ostojaatanasijevic/tube_screamer/README.md

# TPI pedals - TBSCR

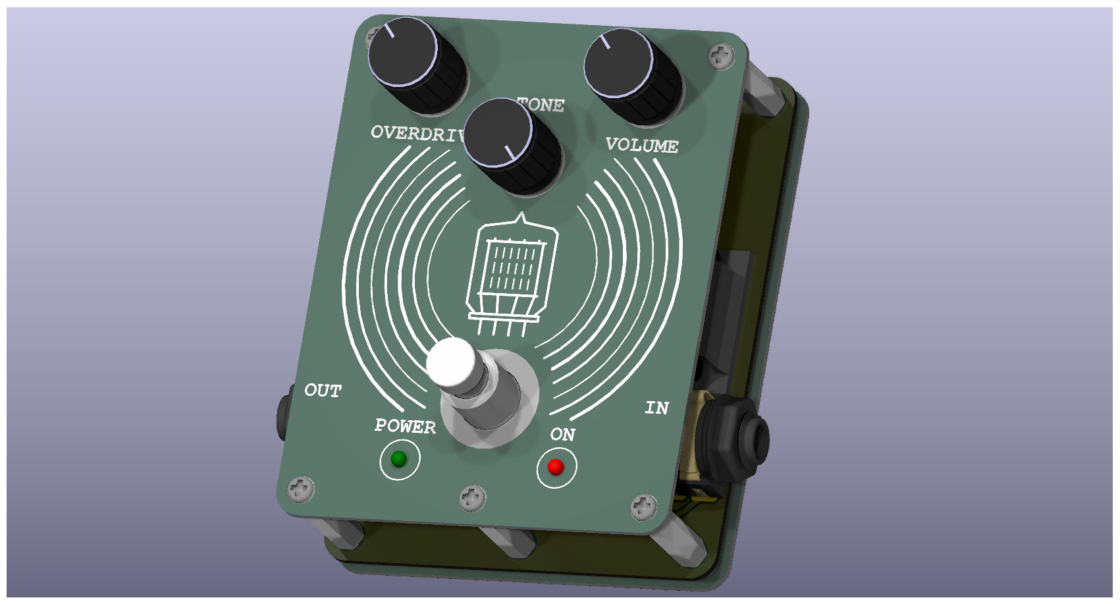
[picture p1: tube_screamer/tube_screamer_side.png]
side_view

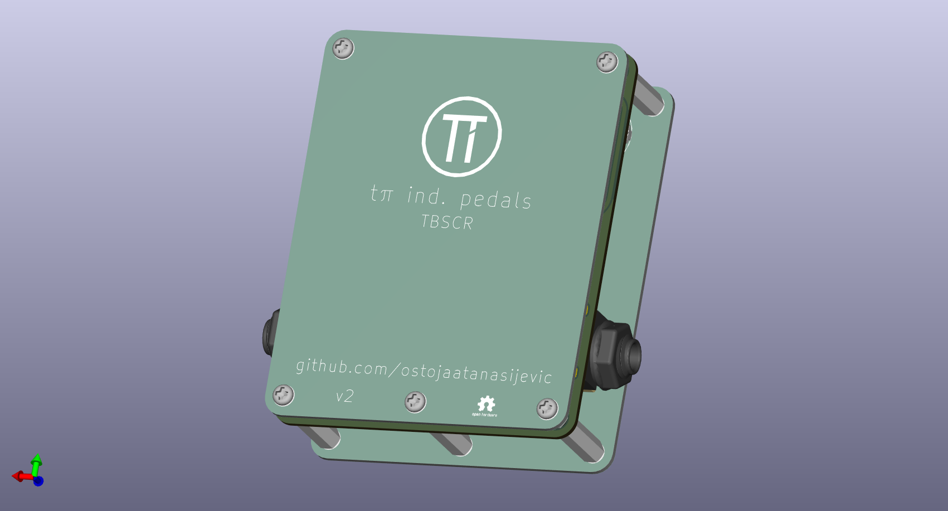
[picture p2: tube_screamer/tube_screamer_bottom.png]
top_view


## Schematic
schematic
