ostojaatanasijevic/tube_screamer/tube_screamer/tube_screamer_top.png

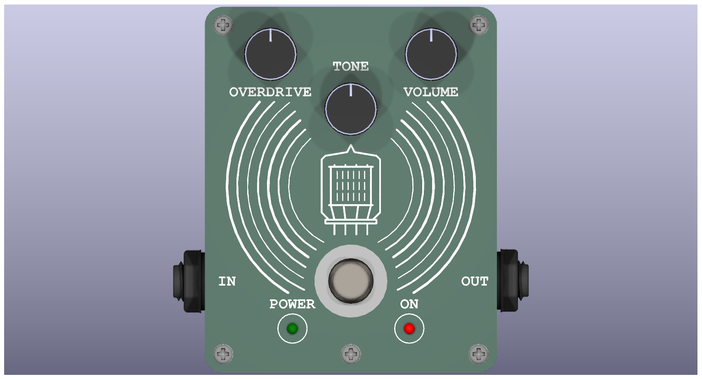
tube_screamer/tube_screamer_top.png
