ostojaatanasijevic/tube_screamer/bottom_plate.step

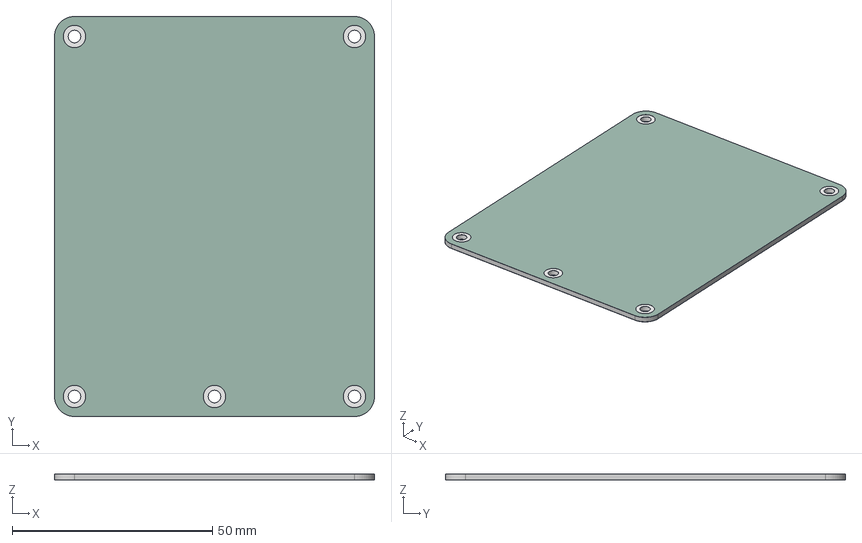
[picture p4: CAD file, 2025-05-22]
bottom_plate.step
80.0 x 100.0 x 1.64 mm
tube_screamer_bottom_plate_pad
tube_screamer_bottom_plate_silkscreen
tube_screamer_bottom_plate_soldermask
tube_screamer_bottom_plate_PCB
