ostojaatanasijevic/tube_screamer/tube_screamer_bottom_plate/tube_screamer_bottom_plate.step

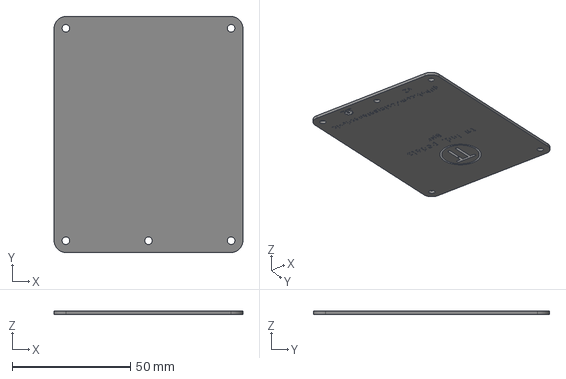
[picture p5: CAD file, 2025-05-13]
tube_screamer_bottom_plate/tube_screamer_bottom_plate.step
80.0 x 100.0 x 1.58 mm
big_muff_pi_bottom_plate_silkscreen
big_muff_pi_bottom_plate_PCB
