ostojaatanasijevic/tube_screamer/tube_screamer_front_plate/tube_screamer_front_plate.step

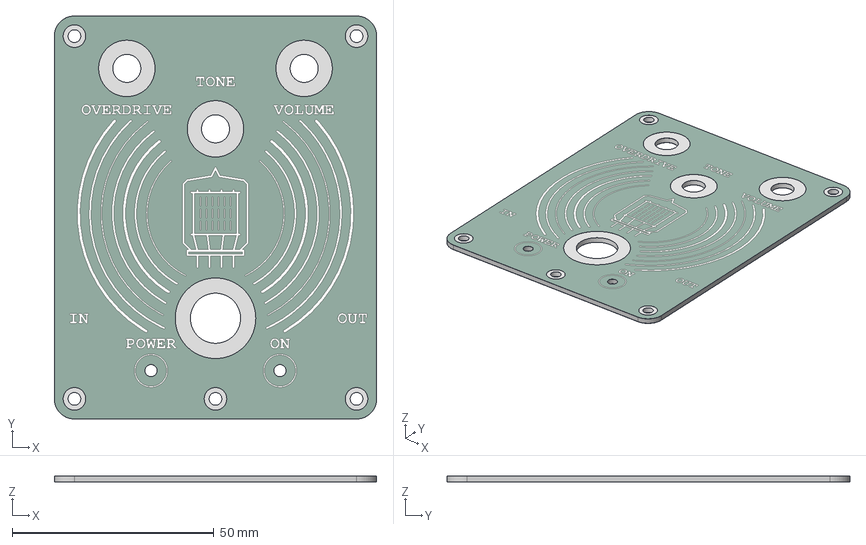
[picture p6: CAD file, 2025-04-02]
tube_screamer_front_plate/tube_screamer_front_plate.step
80.0 x 100.0 x 1.66 mm
tube_screamer_front_plate_copper
tube_screamer_front_plate_pad
tube_screamer_front_plate_silkscreen
tube_screamer_front_plate_soldermask
tube_screamer_front_plate_PCB
