ostojaatanasijevic/tube_screamer/top_plate.step

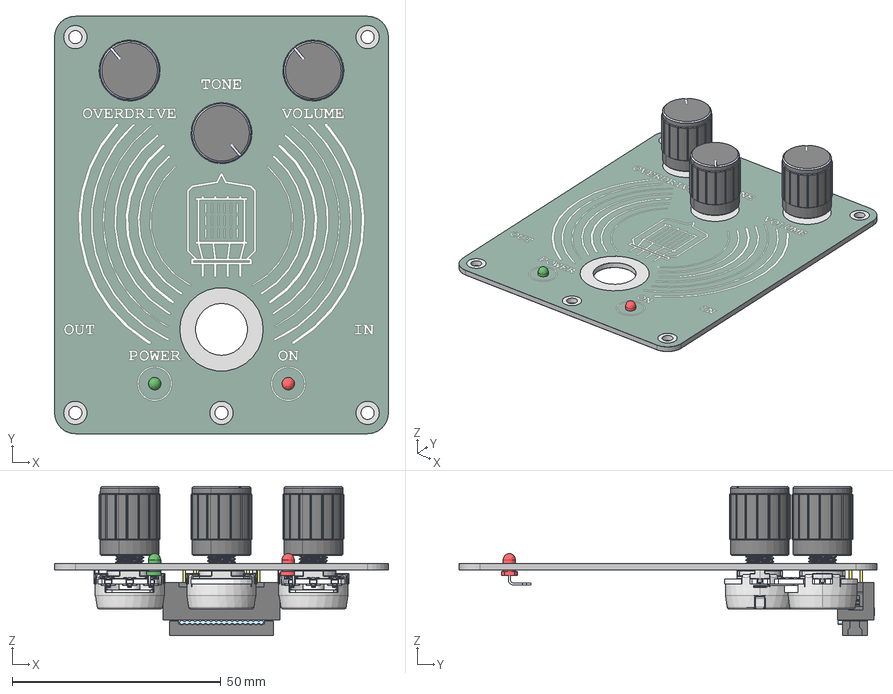
[picture p7: CAD file, 2025-05-22]
top_plate.step
80.0 x 100.0 x 35.8 mm
pcb board x 3
base metal x 3
rotating rod metal x 3
pin x 9
sheild metal x 3
plastic base x 3
Potentiometer knob_A15x17-PK-AB-K-I x 3
LED 3mm, Green, Thru-hole, Right Angle PCB 1
LED 3mm, Red, Thru-hole, Right Angle PCB 1
IDC-Header_2x08_P2.54mm_Vertical
case
clamp
tube_screamer_front_plate_pad
tube_screamer_front_plate_silkscreen
tube_screamer_front_plate_soldermask
tube_screamer_front_plate_PCB
