ostojaatanasijevic/tube_screamer/tube_screamer_bottom_plate/top_plate.step

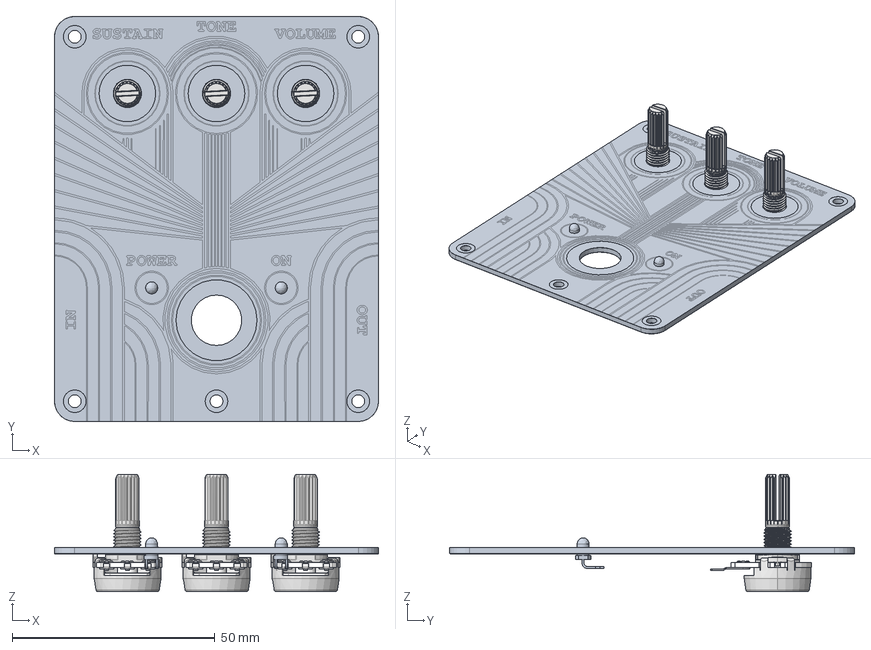
[picture p8: CAD file, 2025-05-13]
tube_screamer_bottom_plate/top_plate.step
80.0 x 100.0 x 29.0 mm
pcb board x 3
base metal x 3
rotating rod metal x 3
pin x 9
sheild metal x 3
plastic base x 3
LED 3mm, Red, Thru-hole, Right Angle PCB 1
LED 3mm, Green, Thru-hole, Right Angle PCB 1
big_muff_pi_front_plate_copper
big_muff_pi_front_plate_pad
big_muff_pi_front_plate_silkscreen
big_muff_pi_front_plate_soldermask
big_muff_pi_front_plate_PCB
