ostojaatanasijevic/tube_screamer/tube_screamer_bottom_plate/3-d-nmj6hhd2.stp

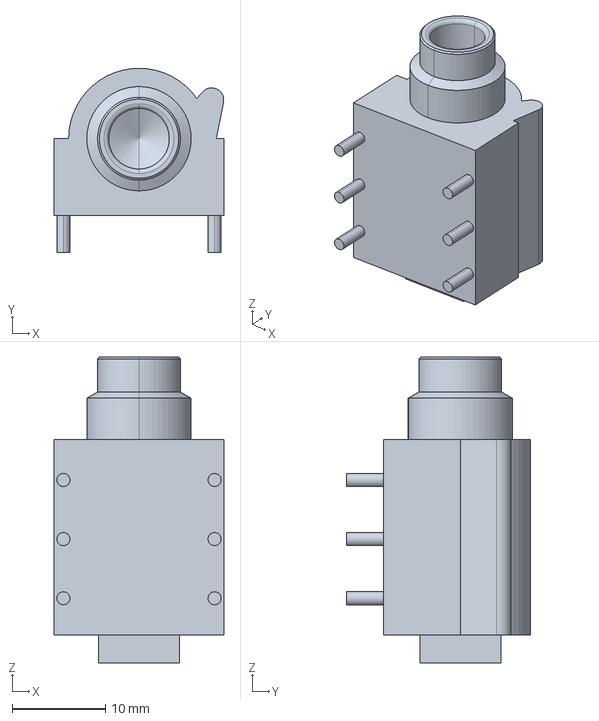
[picture p9: CAD file, 2025-04-05]
tube_screamer_bottom_plate/3-d-nmj6hhd2.stp
18.2 x 19.8 x 32.9 mm
