ostojaatanasijevic/tube_screamer/tube_screamer_bottom_plate/9V-battery.stp

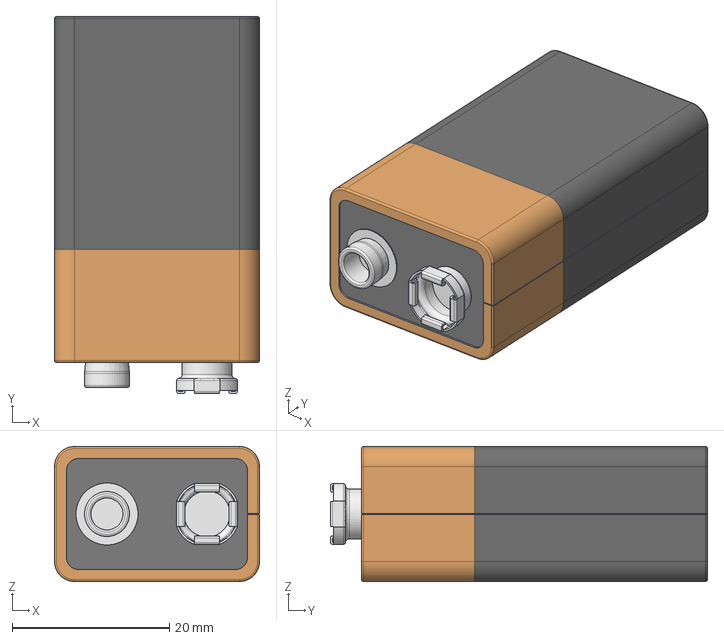
[picture p10: CAD file, 2025-04-01]
tube_screamer_bottom_plate/9V-battery.stp
26.0 x 47.9 x 17.1 mm
