ostojaatanasijevic/tube_screamer/tube_screamer_bottom_plate/NMJ6HFD2-AU--3DModel-STEP-418109.STEP

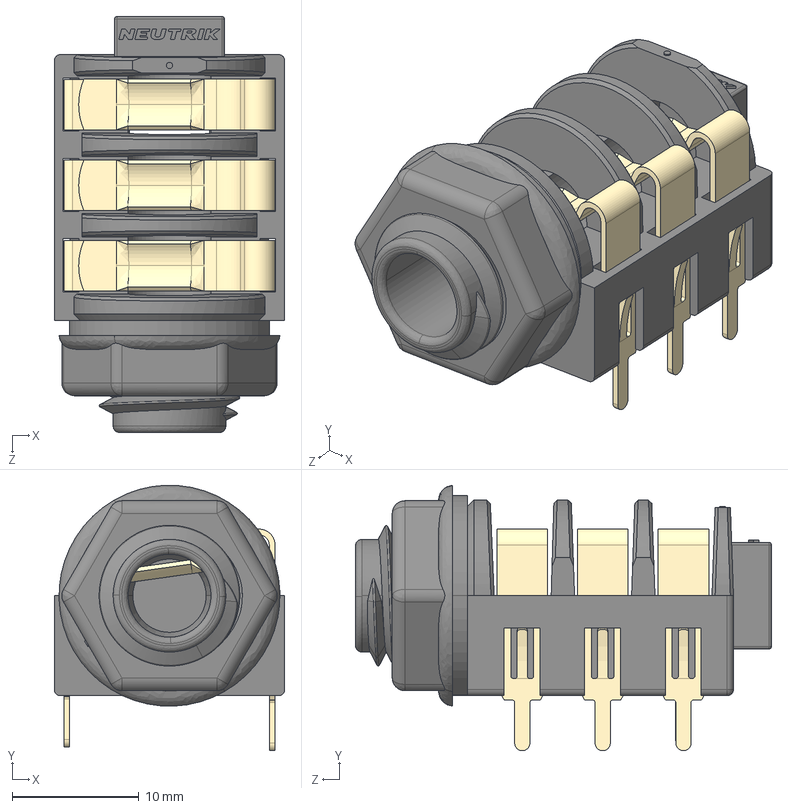
[picture p11: CAD file, 2025-04-01]
tube_screamer_bottom_plate/NMJ6HFD2-AU--3DModel-STEP-418109.STEP
18.2 x 21.0 x 32.9 mm
