ostojaatanasijevic/tube_screamer/tube_screamer_bottom_plate/switch.STEP

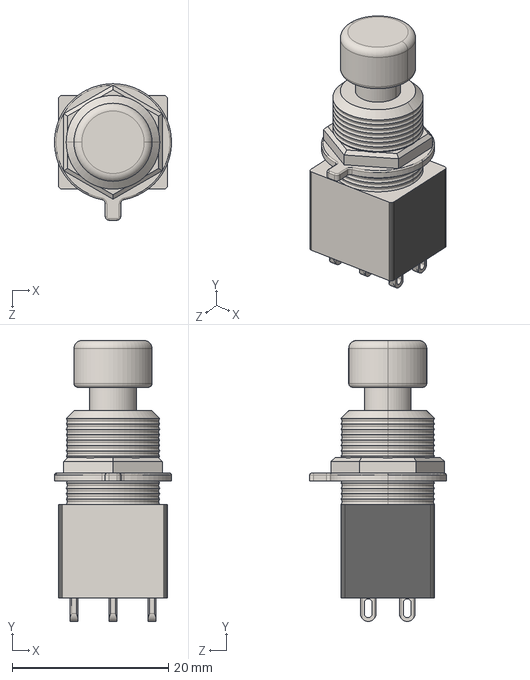
[picture p12: CAD file, 2025-04-01]
tube_screamer_bottom_plate/switch.STEP
15.0 x 36.0 x 17.5 mm
