ostojaatanasijevic/tube_screamer/pmos_enable.asc

M1: nmos; KP723A
M2: pmos; FDS4435A
R1: res; 100
R2: res; 100k
R3: res; 100k
V2: voltage; 10
Named nets: 0
.tran 1m
