ostojaatanasijevic/tube_screamer/tube_screamer/tube_screamer.kicad_pcb

## KiCad design tube_screamer/tube_screamer.kicad_pcb (2025-05-24)

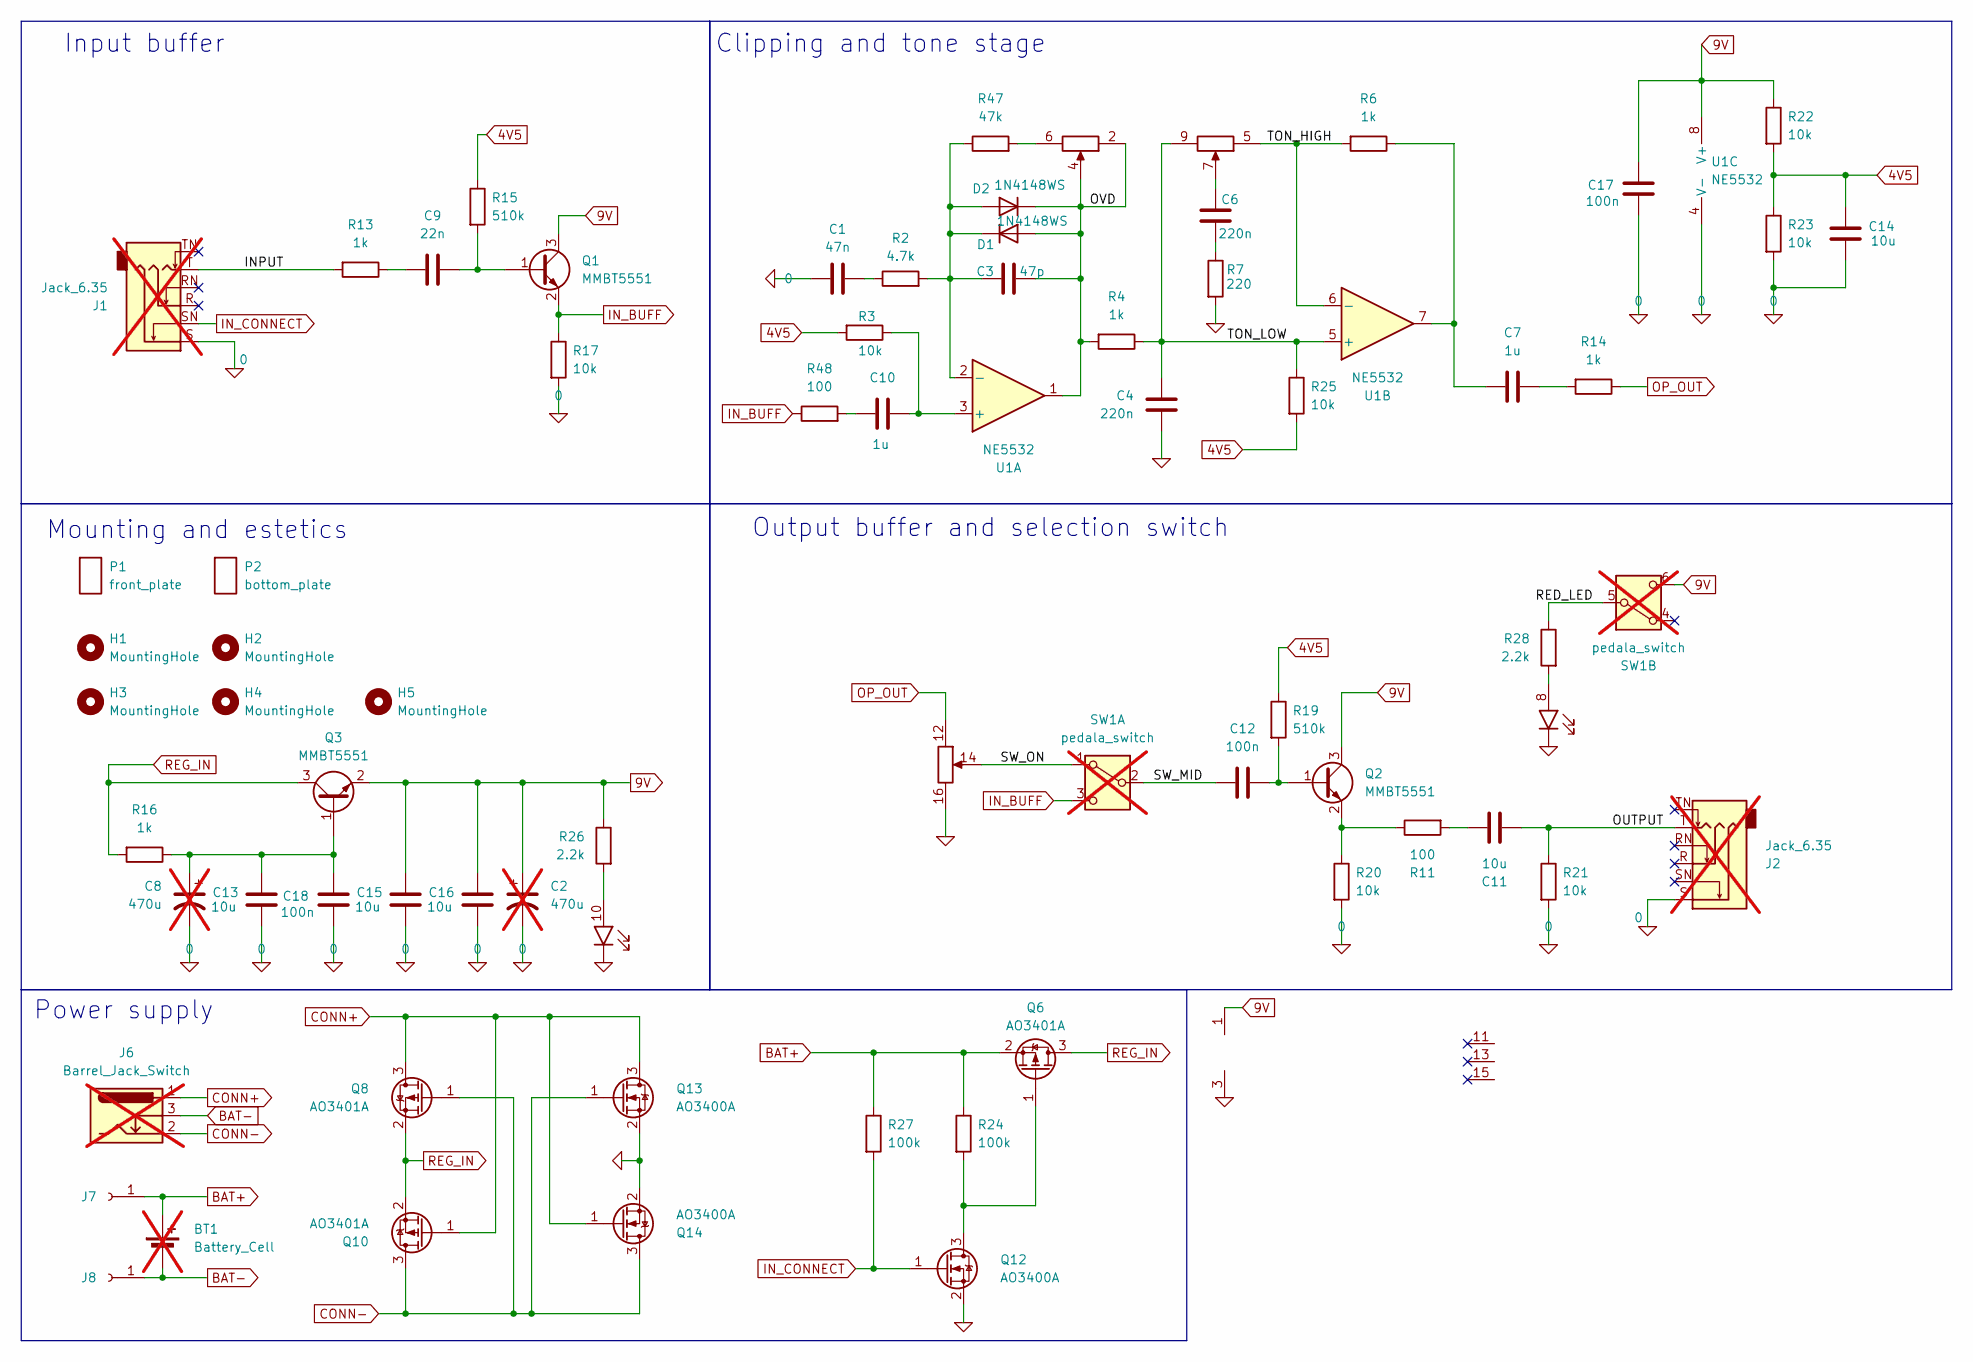
[picture p13: schematic tube_screamer.kicad_sch]

Parts:
BT1: Battery_Cell; BatteryHolder_Eagle_12BH611-GR; not fitted
C1: 47n; C_0603_1608Metric_Pad1.08x0.95mm_HandSolder; LCSC C1622
C2, C8: 470u; CP_Radial_D8.0mm_P3.50mm; not fitted
C3: 47p; C_0603_1608Metric_Pad1.08x0.95mm_HandSolder; LCSC C1671
C4, C6: 220n; C_0603_1608Metric_Pad1.08x0.95mm_HandSolder; LCSC C21120
C7, C10: 1u; C_0603_1608Metric_Pad1.08x0.95mm_HandSolder; LCSC C15849
C9: 22n; C_0603_1608Metric_Pad1.08x0.95mm_HandSolder; LCSC C21122
C11, C13, C14, C15, C16: 10u; C_0603_1608Metric_Pad1.08x0.95mm_HandSolder; LCSC C96446
C12, C17, C18: 100n; C_0603_1608Metric_Pad1.08x0.95mm_HandSolder; LCSC C14663
D1, D2: 1N4148WS; D_SOD-323; LCSC C2128
H1, H2, H3, H4, H5: MountingHole; M3_hole_with_spacer
J1, J2: Jack_6.35; Jack_6.35mm; not fitted
J6: Barrel_Jack_Switch; BarrelJack; not fitted
J7, J8: Conn_01x01_Socket; TestPoint_THTPad_D2.5mm_Drill1.2mm
J9: top_panel_connector; IDC-Header_2x08_P2.54mm_Vertical
P1: front_plate
P2: bottom_plate
Q1, Q2, Q3: MMBT5551; SOT-23; LCSC C2145
Q6, Q8, Q10: AO3401A; SOT-23; LCSC C15127
Q12, Q13, Q14: AO3400A; SOT-23; LCSC C20917
R2: 4.7k; R_0603_1608Metric_Pad0.98x0.95mm_HandSolder; LCSC C23162
R3, R17, R20, R21, R22, R23, R25: 10k; R_0603_1608Metric_Pad0.98x0.95mm_HandSolder; LCSC C25804
R4, R6, R13, R14, R16: 1k; R_0603_1608Metric_Pad0.98x0.95mm_HandSolder; LCSC C21190
R7: 220; R_0603_1608Metric_Pad0.98x0.95mm_HandSolder; LCSC C22962
R11, R48: 100; R_0603_1608Metric_Pad0.98x0.95mm_HandSolder; LCSC C22775
R15, R19: 510k; R_0603_1608Metric_Pad0.98x0.95mm_HandSolder; LCSC C23192
R24, R27: 100k; R_0603_1608Metric_Pad0.98x0.95mm_HandSolder; LCSC C25803
R26, R28: 2.2k; R_0603_1608Metric_Pad0.98x0.95mm_HandSolder; LCSC C4190
R47: 47k; R_0603_1608Metric_Pad0.98x0.95mm_HandSolder; LCSC C25819
SW1: pedala_switch; foot_switch_tht_no_pad; not fitted
U1: NE5532; SOIC-8_3.9x4.9mm_P1.27mm; LCSC C7426

Connections:
0: C1.1, C2.2, C4.1, C8.2, C13.2, C14.2, C15.2, C16.2, C17.1, C18.1, J1.S, J2.S, J9.3 (GND), J9.16, Q12.2 (S), Q13.2 (S), Q14.2 (S), R7.2, R17.2, R20.2, R21.2, R23.2, U1.4 (V-)
4V5: C14.1, R3.2, R15.1, R19.1, R22.2, R23.1, R25.2
9V: C2.1, C15.1, C16.1, C17.2, J9.1 (VCC), Q1.3 (C), Q2.3 (C), Q3.2 (E), R22.1, R26.1, SW1.6 (C), U1.8 (V+)
/INPUT: J1.T, R13.2
/OUTPUT: C11.2, J2.T, R21.1
/OVD: C3.2, D1.2 (A), D2.1 (K), J9.2, J9.4, R4.2, U1.1
/RED_LED: R28.1, SW1.5 (B)
/SW_MID: C12.1, SW1.2 (B)
/SW_ON: J9.14, SW1.1 (A)
/TON_HIGH: J9.5, R6.2, U1.6 (-)
/TON_LOW: C4.2, J9.9, R4.1, R25.1, U1.5 (+)
BAT+: BT1.1 (+), J7.1, Q6.2 (S), R24.1, R27.1
BAT-: BT1.2 (-), J6.3, J8.1
CONN+: J6.1, Q8.3 (D), Q10.1 (G), Q13.3 (D), Q14.1 (G)
CONN-: J6.2, Q8.1 (G), Q10.3 (D), Q13.1 (G), Q14.3 (D)
IN_BUFF: Q1.2 (E), R17.1, R48.1, SW1.3 (C)
IN_CONNECT: J1.SN, Q12.1 (G), R27.2
unnamed: C1.2, R2.1
unnamed: C6.2, R7.1
unnamed: C7.1, R6.1, U1.7
unnamed: C7.2, R14.2
unnamed: C9.1, R13.1
unnamed: C10.1, R48.2
unnamed: C11.1, R11.2
unnamed: C3.1, D1.1 (K), D2.2 (A), R2.2, R47.1, U1.2 (-)
unnamed: J9.6, R47.2
unnamed: C6.1, J9.7
unnamed: J9.8, R28.2
unnamed: J9.10, R26.2
unnamed: C9.2, Q1.1 (B), R15.2
unnamed: C12.2, Q2.1 (B), R19.2
unnamed: Q2.2 (E), R11.1, R20.1
unnamed: C8.1, C13.1, C18.2, Q3.1 (B), R16.1
unnamed: Q6.1 (G), Q12.3 (D), R24.2
unnamed: C10.2, R3.1, U1.3 (+)
OP_OUT: J9.12, R14.1
REG_IN: Q3.3 (C), Q6.3 (D), Q8.2 (S), Q10.2 (S), R16.2

Notes on the sheet:
Input buffer
Mounting and estetics
Clipping and tone stage
Output buffer and selection switch
Power supply

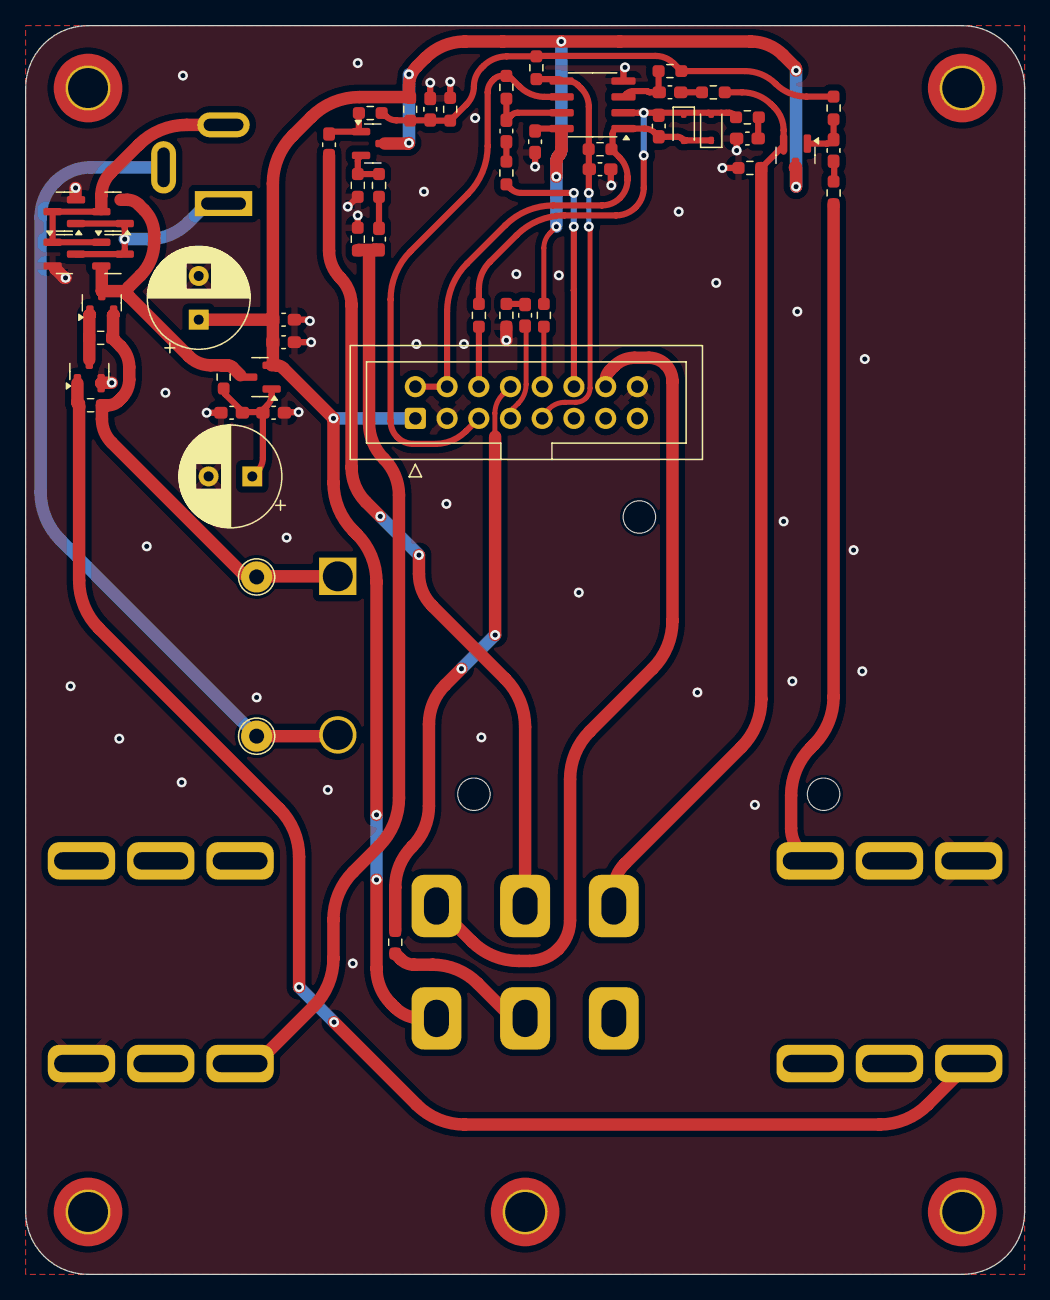
[picture p14: board tube_screamer.kicad_pcb from above]

Board: 2 copper layers, 80.0 x 100.0 mm, 67 parts (0 on the bottom side), 37 nets.
