ostojaatanasijevic/tube_screamer/tube_screamer_front_plate/tube_screamer_front_plate.kicad_pcb

## KiCad design tube_screamer_front_plate/tube_screamer_front_plate.kicad_pcb (2025-05-24)

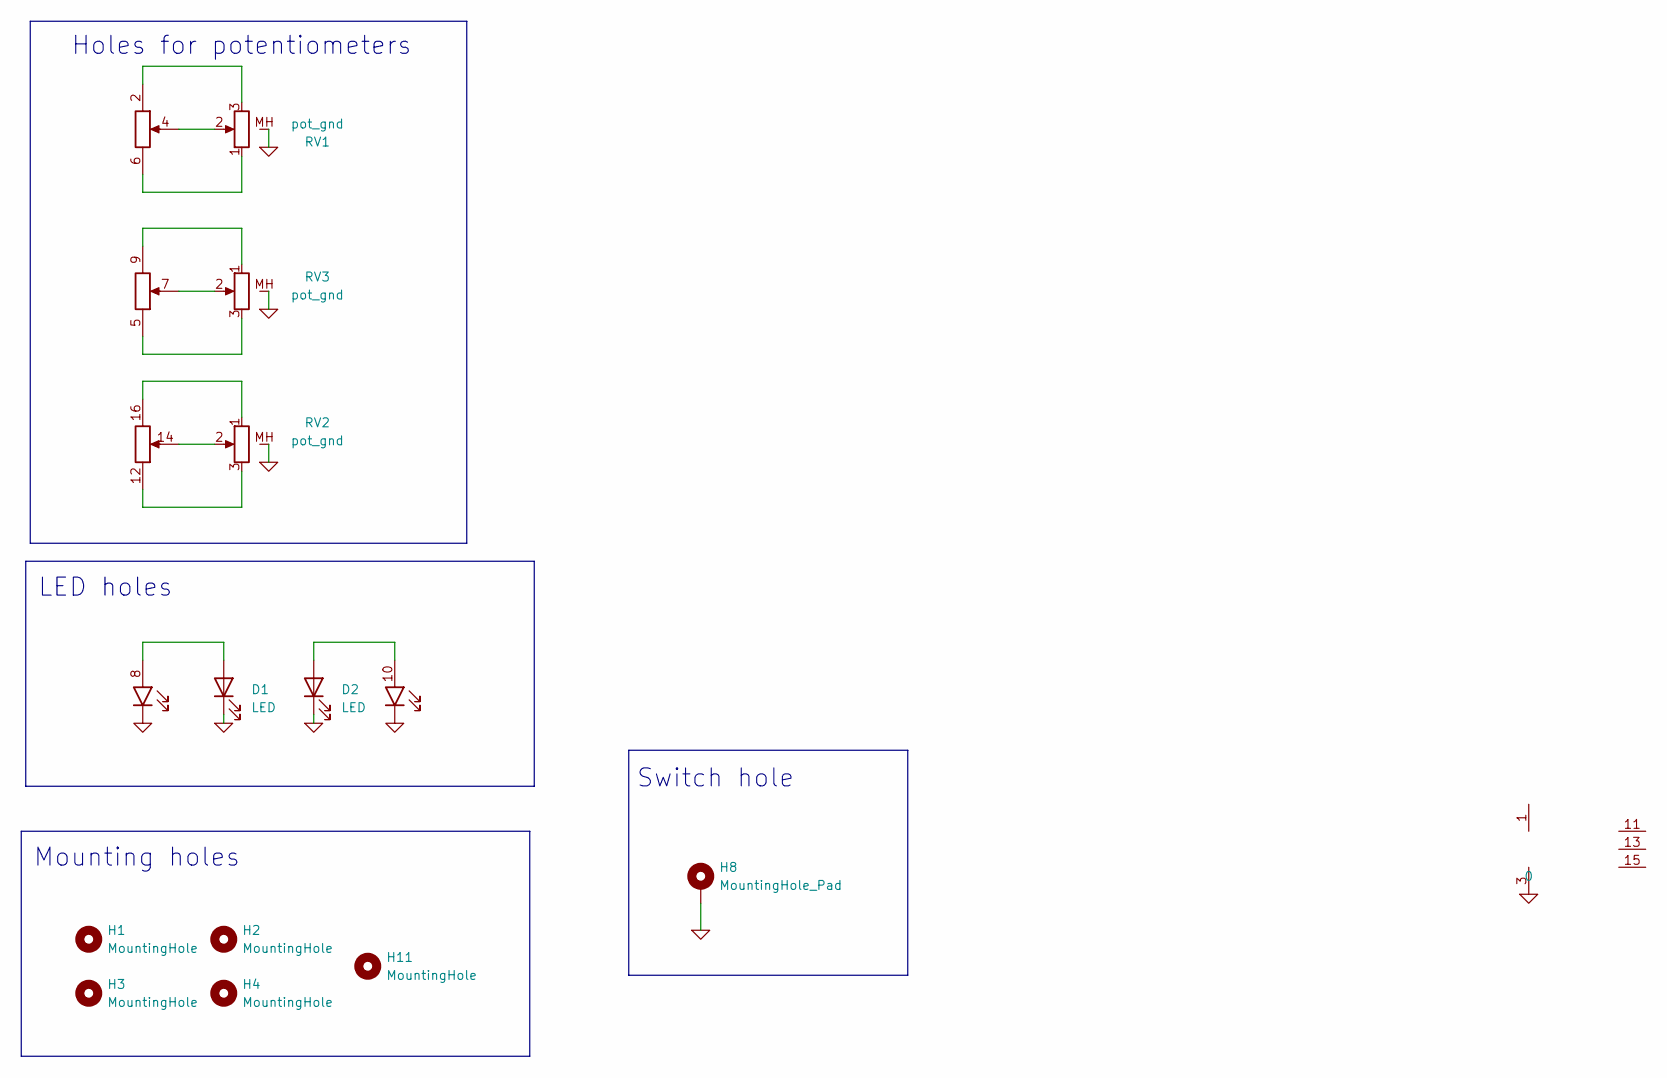
[picture p15: schematic tube_screamer_front_plate.kicad_sch]

Parts:
D1: LED; red_led
D2: LED; green_led
H1, H2, H3, H4, H11: MountingHole; MountingHole_3.2mm_M3_DIN965_Pad_TopBottom
H8: MountingHole_Pad; plated_switch_hole
J1: top_panel_connector; IDC-Header_2x08_faux_SMD
RV1, RV2, RV3: pot_gnd; top_plate_pot

Connections:
0: D1.1 (K), D2.1 (K), H8.1, J1.3 (GND), RV1.MH (2), RV2.MH (2), RV3.MH (2)
unnamed: D1.2 (A), J1.8
unnamed: D2.2 (A), J1.10 (1)
unnamed: J1.2, RV1.3
unnamed: J1.4, RV1.2
unnamed: J1.6, RV1.1
unnamed: J1.5, RV3.3
unnamed: J1.7, RV3.2
unnamed: J1.9, RV3.1
unnamed: J1.12, RV2.3
unnamed: J1.14, RV2.2
unnamed: J1.16, RV2.1

Notes on the sheet:
Holes for potentiometers
LED holes
Mounting holes
Switch hole

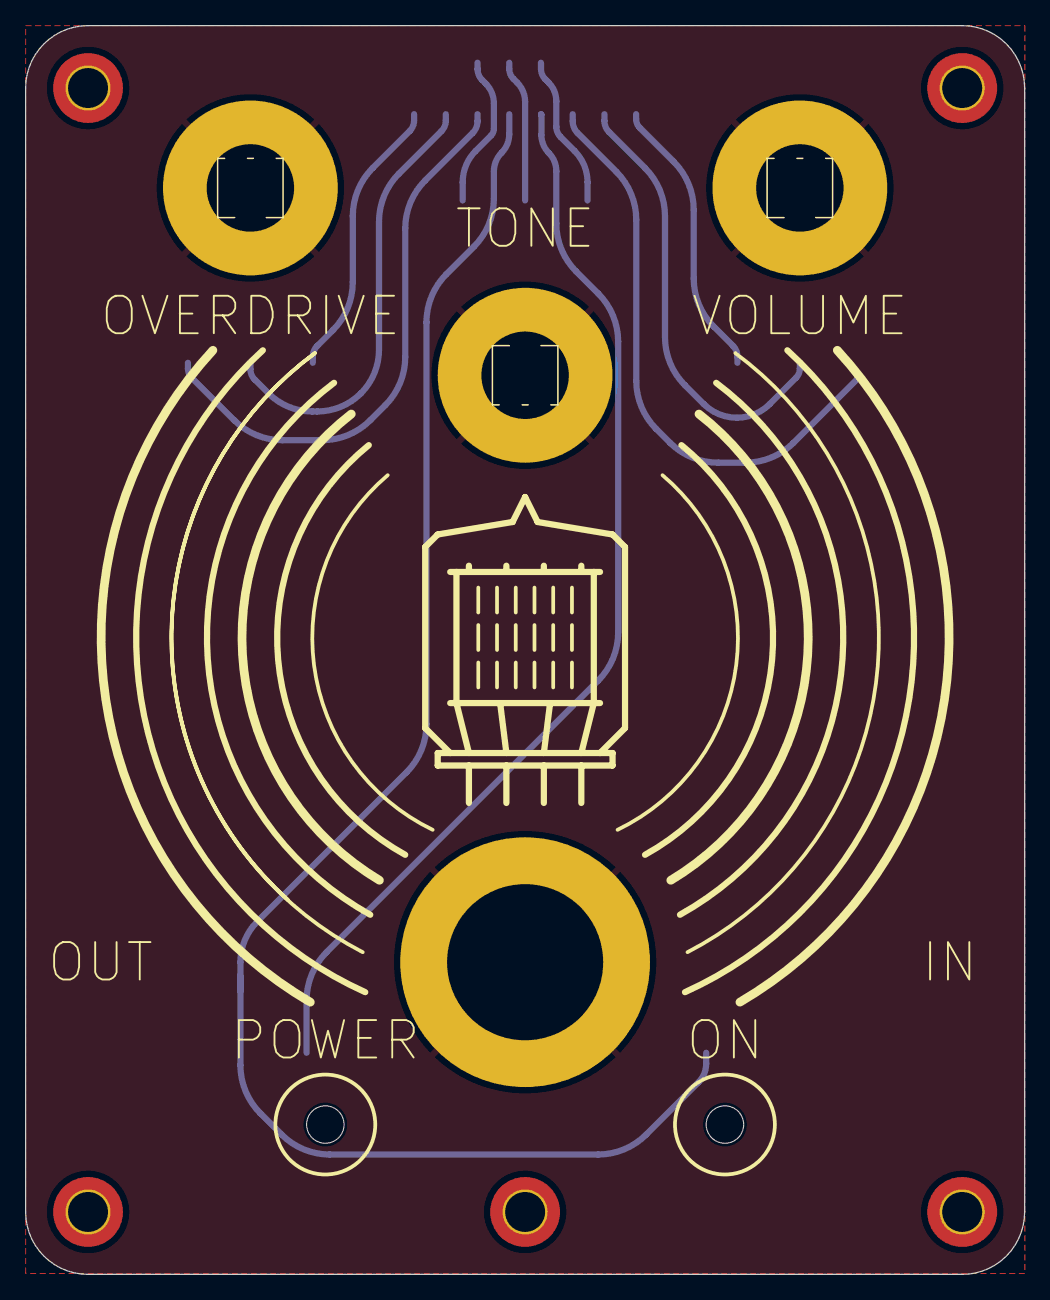
[picture p16: board tube_screamer_front_plate.kicad_pcb from above]

Board: 2 copper layers, 80.0 x 100.0 mm, 12 parts (1 on the bottom side), 12 nets.
