ostojaatanasijevic/tube_screamer/(commit log)

2025-03-29 PCB layout.
    [tube_screamer.kicad_pcb, tube_screamer.kicad_sch]
2025-03-29 PCB update.
    [tube_screamer.kicad_pcb, tube_screamer.kicad_sch]
2025-03-30 Updated schematic
    [tube_screamer.kicad_pcb, tube_screamer.kicad_sch]
2025-03-30 Updated schematic and layout.
    [tube_screamer.kicad_pcb, tube_screamer.kicad_sch]
2025-03-30 poredjani potenciometri, layout na pola puta
    [tube_screamer.kicad_pcb]
2025-03-30 Changed opamp to NE5532, basic LCSC part.
    [tube_screamer.kicad_pcb, tube_screamer.kicad_sch]
2025-03-31 Added switch connectors.
    [tube_screamer.kicad_pcb, tube_screamer.kicad_sch]
2025-03-31 Updated switch, added diode.
    [tube_screamer.kicad_pcb, tube_screamer.kicad_sch]
2025-04-01 Added connectors and switch.
    [NMJ6HFD2-AU--3DModel-STEP-418109.STEP, switch.STEP, tube_screamer.kicad_pcb, tube_screamer.kicad_sch]
2025-04-01 new lib
    [tube_screamer.kicad_pcb]
2025-04-02 Goin well.
    [tube_screamer.kicad_pcb, tube_screamer.kicad_sch]
2025-04-02 3D bodies
    [tube_screamer.kicad_pcb, tube_screamer.kicad_sch]
2025-04-02 Schematic cleaned.
    [tube_screamer.kicad_sch]
2025-04-02 Schem fix
    [tube_screamer.kicad_sch]
2025-04-03 Schematic fix, PCB final
    [tube_screamer.kicad_pcb, tube_screamer.kicad_sch]
2025-04-05 All errors removed
    [switch.STEP, tube_screamer.kicad_pcb, tube_screamer.kicad_sch]
2025-04-06 Production files v1.
    [bom.csv, designators.csv, positions.csv, tube_screamer.kicad_pcb, tube_screamer.kicad_sch]
2025-04-20 Rotirani pinovi audio konektora, rotirani LED prekidač pinovi.
    [tube_screamer.kicad_pcb, tube_screamer.kicad_sch]
2025-05-06 New management.
    [bom.csv, designators.csv, positions.csv, top_plate.step, tube_screamer.kicad_pcb, tube_screamer.kicad_sch]
2025-05-06 new mna
    [3-d-nmj6hhd2.stp, 9V-battery.stp, NMJ6HFD2-AU--3DModel-STEP-418109.STEP, switch.STEP, tube_screamer_front_plate.kicad_pcb, tube_screamer_front_plate.kicad_sch, tube_screamer_front_plate.step]
2025-05-09 Top plate update.
    [top_plate.step, tube_screamer_front_plate.kicad_pcb, tube_screamer_front_plate.kicad_sch]
2025-05-09 Pots fit, battery holder has to be moved.
    [tube_screamer.kicad_pcb, tube_screamer.kicad_sch]
2025-05-09 Update library.
    [tube_screamer.kicad_pcb]
2025-05-13 Added bottom plate.
    [3-d-nmj6hhd2.stp, 9V-battery.stp, NMJ6HFD2-AU--3DModel-STEP-418109.STEP, switch.STEP, top_plate.step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]
2025-05-13 Generated models.
    [bottom_plate.step, top_plate.step]
2025-05-13 Updated, added 3d bodies.
    [tube_screamer.kicad_pcb, tube_screamer.kicad_sch]
2025-05-13 Update schematic.
    [tube_screamer.kicad_pcb, tube_screamer.kicad_sch, tube_screamer_front_plate.kicad_pcb, tube_screamer_front_plate.kicad_sch]
2025-05-14 1 Red, 3 green connector.
    [tube_screamer.kicad_pcb, tube_screamer.kicad_sch, tube_screamer_front_plate.kicad_pcb, tube_screamer_front_plate.kicad_sch]
2025-05-14 Pots checked, all good.
    [tube_screamer.kicad_sch, tube_screamer_front_plate.kicad_pcb, tube_screamer_front_plate.kicad_sch]
2025-05-19 Fixed diodes on front plate, fixed power schem.
    [tube_screamer.kicad_pcb, tube_screamer.kicad_sch, tube_screamer_front_plate.kicad_pcb, tube_screamer_front_plate.kicad_sch]
2025-05-21 Updated libraries.
    [tube_screamer.kicad_pcb, tube_screamer.kicad_sch]
2025-05-21 IDC connector moved.
    [tube_screamer.kicad_pcb]
2025-05-21 Tube screamer front plate done, library updated.
    [tube_screamer_front_plate.kicad_pcb, tube_screamer_front_plate.kicad_sch]
2025-05-21 GND to top.
    [tube_screamer_front_plate.kicad_pcb, tube_screamer_front_plate.kicad_sch]
2025-05-22 Checklist done, only layout left.
    [tube_screamer.kicad_pcb, tube_screamer.kicad_sch]
2025-05-22 Added label to front plate botom.
    [tube_screamer_front_plate.kicad_pcb]
2025-05-22 2.2 kOhm LED resistance.
    [tube_screamer.kicad_pcb, tube_screamer.kicad_sch]
2025-05-22 Top plate rounded.
    [tube_screamer_front_plate.kicad_pcb]
2025-05-22 Updated 3D bodies.
    [tube_screamer.kicad_pcb]
2025-05-24 Layout done.
    [tube_screamer.kicad_pcb]
2025-05-24 Ready for production.
    [bom.csv, designators.csv, positions.csv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]
